mishun/nixie/controller.brd

## EAGLE design controller.brd (2013-10-05)

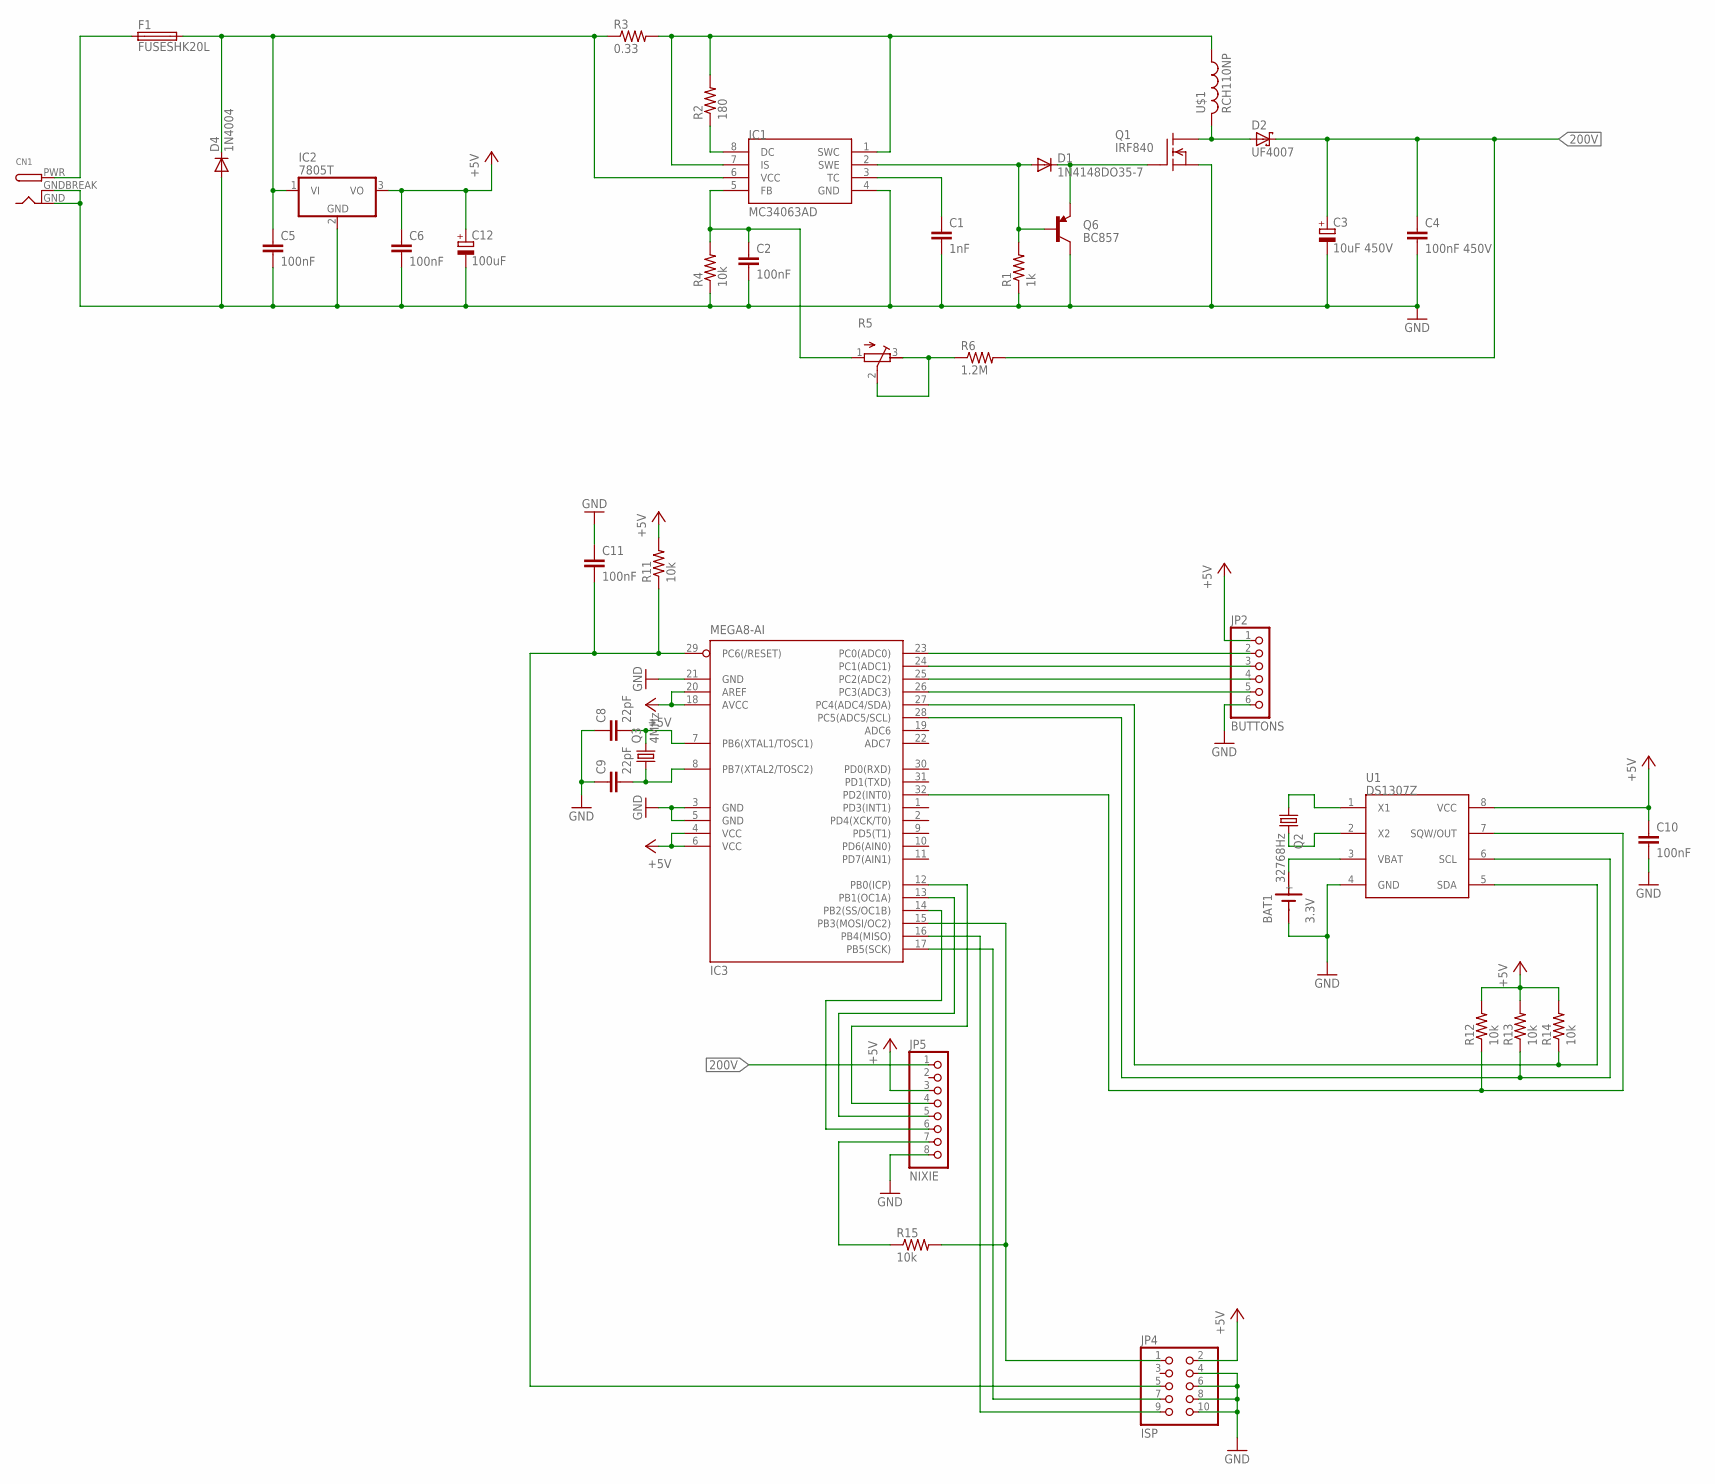
[picture p1: schematic controller.sch]

Parts:
BAT1: 3.3V; SN2032
C1: 1nF; 0805
C2, C5, C6, C10, C11: 100nF; 0805
C3: 10uF 450V; E5-13
C4: 100nF 450V; CAP-PTH-LARGE
C8, C9: 22pF; 0805
C12: 100uF; E3,5-8
CN1: DCBARRELPTH; DCJACK_2MM_PTH
D1: 1N4148DO35-7; DO35-7
D2: UF4007; DO41-7.6
D4: 1N4004; DO41-10
F1: FUSESHK20L; SHK20L
IC1: MC34063AD; SOIC8
IC2: 7805T; TO220H
IC3: MEGA8-AI; TQFP32-08
JP2: BUTTONS; 1X06/90
JP4: ISP; 2X05/90
JP5: NIXIE; 1X08
Q1: IRF840; TO220
Q2: 32768Hz; TC38H
Q3: 4MHz; HC49U-V
Q6: BC857; SOT23-3
R1: 1k; 0805
R2: 180; 0805
R3: 0.33; AXIAL-0.8
R4, R11, R12, R13, R14, R15: 10k; 0805
R5: R-TRIMM64Z; RTRIM64Z
R6: 1.2M; AXIAL-0.8
U1: DS1307Z; SOIC8
U$1: RCH110NP

Connections:
200V: C3.+, C4.1, D2.C, JP5.1, R6.P$2 (2)
+5V: C6.1, C10.1, C12.+, IC2.3 (VO), IC3.4 (VCC), IC3.6 (VCC), IC3.18 (AVCC), IC3.20 (AREF), JP2.1, JP4.2, JP5.3, R11.2, R12.2, R13.2, R14.2, U1.8 (VCC)
GND: BAT1.-, C1.2, C2.2, C3.-, C4.2, C5.2, C6.2, C8.1, C9.1, C10.2, C11.1, C12.-, CN1.GND, CN1.GNDBREAK, D4.A, IC1.4 (GND), IC2.2 (GND), IC3.3 (GND), IC3.5 (GND), IC3.21 (GND), JP2.6, JP4.4, JP4.6, JP4.8, JP4.10, JP5.8, Q1.3 (S), Q6.3 (C), R1.1, R4.1, U1.4 (GND)
unnamed: D1.C, Q1.1 (G), Q6.2 (E)
unnamed: D1.A, IC1.2 (SWE), Q6.1 (B), R1.2
unnamed: IC3.23 (PC0(ADC0)), JP2.2
unnamed: D2.A, Q1.2 (D), U$1.B (2)
unnamed: C1.1, IC1.3 (TC)
unnamed: IC1.8 (DC), R2.1
unnamed: IC1.1 (SWC), IC1.7 (IS), R2.2, R3.P$2 (2), U$1.A (1)
unnamed: C5.1, D4.C, F1.2A (2), IC1.6 (VCC), IC2.1 (VI), R3.P$1 (1)
unnamed: C11.2, IC3.29 (PC6(/RESET)), JP4.5, R11.1
unnamed: C2.1, IC1.5 (FB), R4.2, R5.1 (A)
unnamed: R5.2 (S), R5.3 (E), R6.P$1 (1)
unnamed: IC3.27 (PC4(ADC4/SDA)), R14.1, U1.5 (SDA)
unnamed: IC3.24 (PC1(ADC1)), JP2.3
unnamed: IC3.25 (PC2(ADC2)), JP2.4
unnamed: IC3.26 (PC3(ADC3)), JP2.5
unnamed: IC3.28 (PC5(ADC5/SCL)), R13.1, U1.6 (SCL)
unnamed: IC3.32 (PD2(INT0)), R12.1, U1.7 (SQW/OUT)
unnamed: IC3.15 (PB3(MOSI/OC2)), JP4.1, R15.2
unnamed: IC3.17 (PB5(SCK)), JP4.7
unnamed: IC3.16 (PB4(MISO)), JP4.9
unnamed: BAT1.+, U1.3 (VBAT)
unnamed: IC3.12 (PB0(ICP)), JP5.4
unnamed: Q2.1, U1.1 (X1)
unnamed: Q2.2, U1.2 (X2)
unnamed: C8.2, IC3.7 (PB6(XTAL1/TOSC1)), Q3.2
unnamed: C9.2, IC3.8 (PB7(XTAL2/TOSC2)), Q3.1
unnamed: CN1.PWR, F1.1A (1)
unnamed: IC3.13 (PB1(OC1A)), JP5.5
unnamed: IC3.14 (PB2(SS/OC1B)), JP5.6
unnamed: JP5.7, R15.1

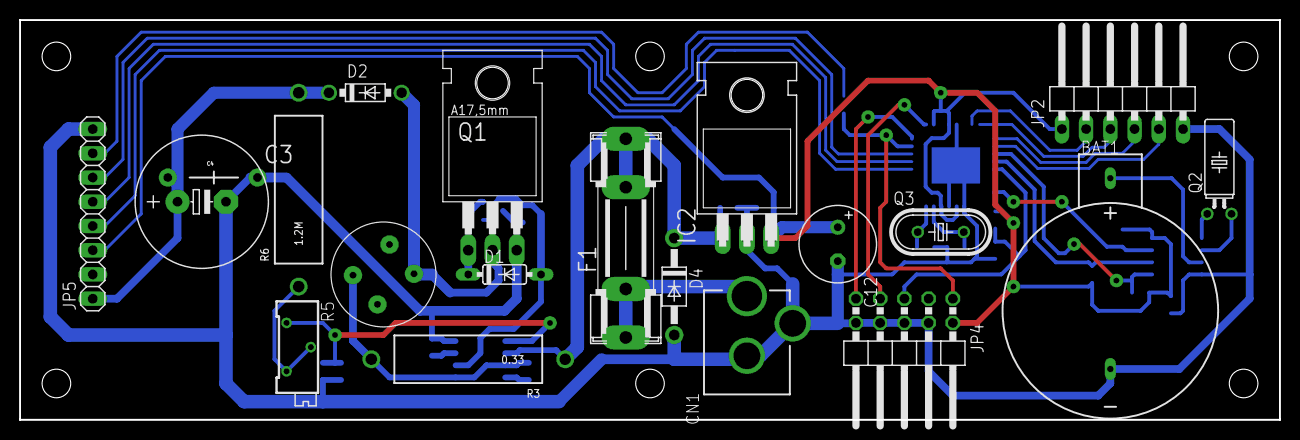
[picture p2: board controller.brd from above]

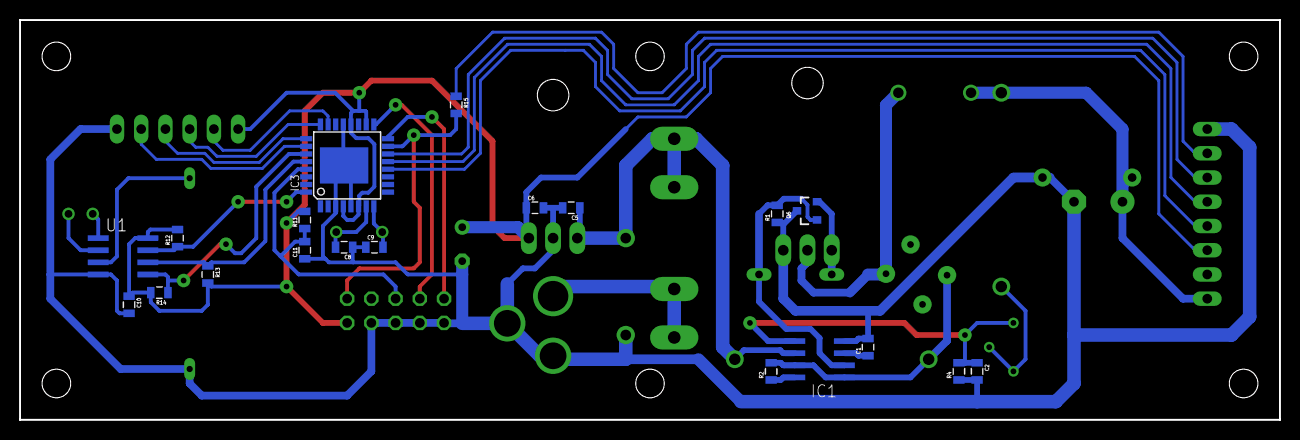
[picture p3: board controller.brd from below]

Board: 2 copper layers, 132.1 x 41.9 mm, 40 parts (20 on the bottom side), 33 nets.
