mishun/nixie/in14-4.brd

## EAGLE design in14-4.brd (2013-08-27)

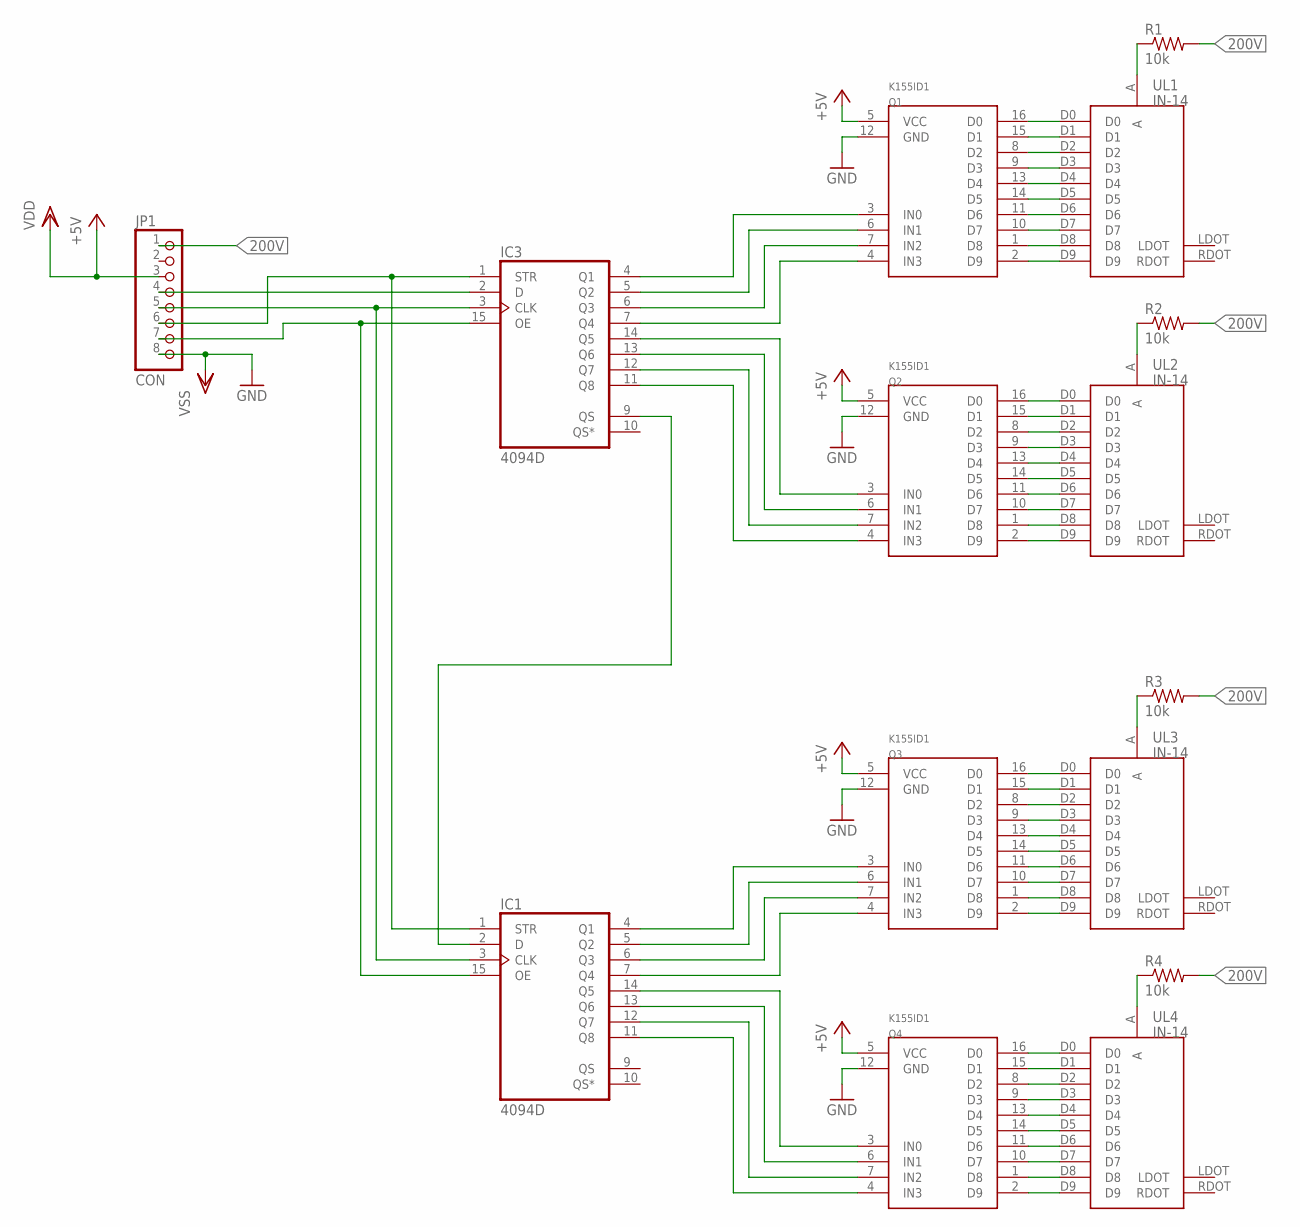
[picture p4: schematic in14-4.sch]

Parts:
IC1, IC3: 4094D; SO16
JP1: CON; 1X08
Q1, Q2, Q3, Q4: K155ID1; DIL16
R1, R2, R3, R4: 10k; 1206
UL1, UL2, UL3, UL4: IN-14

Connections:
200V: JP1.1, R1.2, R2.2, R3.2, R4.2
+5V: IC1.16 (VDD), IC3.16 (VDD), JP1.3, Q1.5 (VCC), Q2.5 (VCC), Q3.5 (VCC), Q4.5 (VCC)
GND: IC1.8 (VSS), IC3.8 (VSS), JP1.8, Q1.12 (GND), Q2.12 (GND), Q3.12 (GND), Q4.12 (GND)
unnamed: Q1.16 (D0), UL1.D0
unnamed: Q1.15 (D1), UL1.D1
unnamed: Q1.8 (D2), UL1.D2
unnamed: Q1.9 (D3), UL1.D3
unnamed: Q1.13 (D4), UL1.D4
unnamed: Q1.14 (D5), UL1.D5
unnamed: Q1.11 (D6), UL1.D6
unnamed: Q1.10 (D7), UL1.D7
unnamed: Q1.1 (D8), UL1.D8
unnamed: Q1.2 (D9), UL1.D9
unnamed: R1.1, UL1.A
unnamed: Q2.16 (D0), UL2.D0
unnamed: Q2.15 (D1), UL2.D1
unnamed: Q2.8 (D2), UL2.D2
unnamed: Q2.9 (D3), UL2.D3
unnamed: Q2.13 (D4), UL2.D4
unnamed: Q2.14 (D5), UL2.D5
unnamed: Q2.11 (D6), UL2.D6
unnamed: Q2.10 (D7), UL2.D7
unnamed: Q2.1 (D8), UL2.D8
unnamed: Q2.2 (D9), UL2.D9
unnamed: R2.1, UL2.A
unnamed: Q3.2 (D9), UL3.D9
unnamed: IC3.5 (Q2), Q1.6 (IN1)
unnamed: Q3.11 (D6), UL3.D6
unnamed: IC3.13 (Q6), Q2.6 (IN1)
unnamed: IC3.12 (Q7), Q2.7 (IN2)
unnamed: IC3.11 (Q8), Q2.4 (IN3)
unnamed: IC3.2 (D), JP1.4
unnamed: IC1.3 (CLK), IC3.3 (CLK), JP1.5
unnamed: IC1.1 (STR), IC3.1 (STR), JP1.6
unnamed: IC1.15 (OE), IC3.15 (OE), JP1.7
unnamed: IC1.7 (Q4), Q3.4 (IN3)
unnamed: IC1.6 (Q3), Q3.7 (IN2)
unnamed: IC1.5 (Q2), Q3.6 (IN1)
unnamed: IC1.4 (Q1), Q3.3 (IN0)
unnamed: IC1.14 (Q5), Q4.3 (IN0)
unnamed: IC1.13 (Q6), Q4.6 (IN1)
unnamed: IC1.12 (Q7), Q4.7 (IN2)
unnamed: IC1.11 (Q8), Q4.4 (IN3)
unnamed: Q3.16 (D0), UL3.D0
unnamed: Q3.15 (D1), UL3.D1
unnamed: Q3.8 (D2), UL3.D2
unnamed: Q3.9 (D3), UL3.D3
unnamed: Q3.13 (D4), UL3.D4
unnamed: Q3.14 (D5), UL3.D5
unnamed: Q3.10 (D7), UL3.D7
unnamed: Q3.1 (D8), UL3.D8
unnamed: Q4.16 (D0), UL4.D0
unnamed: Q4.15 (D1), UL4.D1
unnamed: Q4.8 (D2), UL4.D2
unnamed: Q4.9 (D3), UL4.D3
unnamed: Q4.13 (D4), UL4.D4
unnamed: Q4.14 (D5), UL4.D5
unnamed: Q4.11 (D6), UL4.D6
unnamed: Q4.10 (D7), UL4.D7
unnamed: Q4.1 (D8), UL4.D8
unnamed: Q4.2 (D9), UL4.D9
unnamed: IC3.4 (Q1), Q1.3 (IN0)
unnamed: R3.1, UL3.A
unnamed: R4.1, UL4.A
unnamed: IC1.2 (D), IC3.9 (QS)
unnamed: IC3.7 (Q4), Q1.4 (IN3)
unnamed: IC3.6 (Q3), Q1.7 (IN2)
unnamed: IC3.14 (Q5), Q2.3 (IN0)

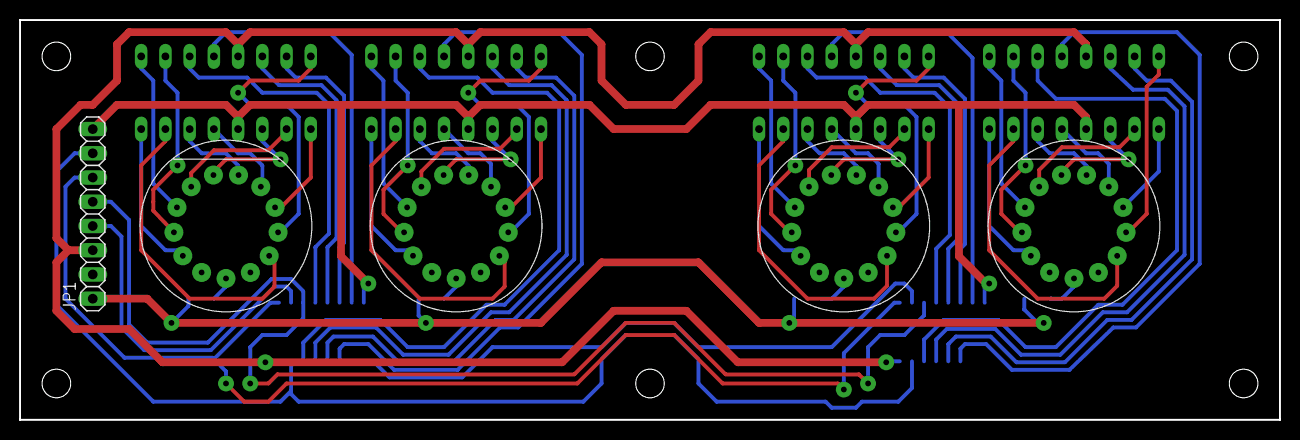
[picture p5: board in14-4.brd from above]

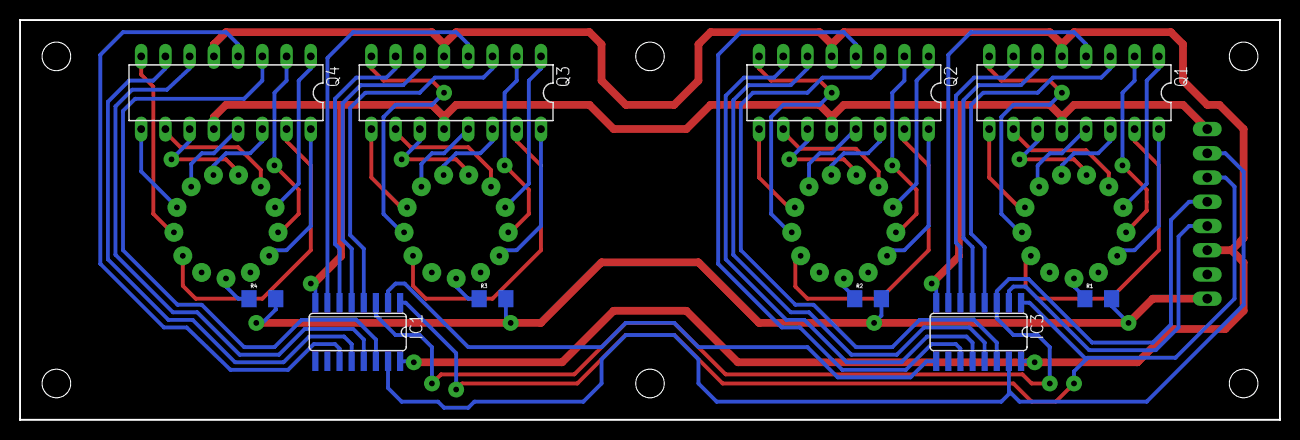
[picture p6: board in14-4.brd from below]

Board: 2 copper layers, 132.1 x 41.9 mm, 15 parts (10 on the bottom side), 68 nets.
