mishun/nixie/todo.txt

- add filter capacitor
- make thermal pads under 7805 and IRF840
- select voltage pot
