mishun/nixie/(commit log)

2012-08-26 Existing files added
    [controller.sch, in14-4.brd, in14-4.sch]
2012-08-31 Finishing extra components
    [controller.brd, controller.sch]
2012-09-14 Fixing ERC errors
    [in14-4.brd, in14-4.sch]
2012-09-15 Dimensions defined
    [controller.brd, in14-4.brd]
2013-08-17 IN-14 layers fix
    [in14-4.brd, in14-4.sch]
2013-09-13 Controller prototype finished
    [controller.brd, controller.sch]
2013-10-02 Async I2C + Watchdog
2013-10-02 PWM brightness control
2013-10-02 Possible race condition in I2C fix
    [nixie.cpp]
2013-10-02 Sensor buttons implementation started + date and time routines
2013-10-05 Correct pnp transistor pinout
    [controller.brd, controller.sch]
